manideepsai-art/sartac-vishwakarma-2026/README.md

# sartac-vishwakarma-2026
SARTAC: AI-Powered Caged Drone for Collapsed-Structure Search and Rescue

A drone concept designed to support search-and-rescue operations in collapsed structures by improving situational awareness and reducing uncertainty for rescue teams.

TEAM: LogicVolt

Institution: NIT RAIPUR
