manideepsai-art/sartac-vishwakarma-2026/CAD/Screenshot 2026-10-25 131847.png

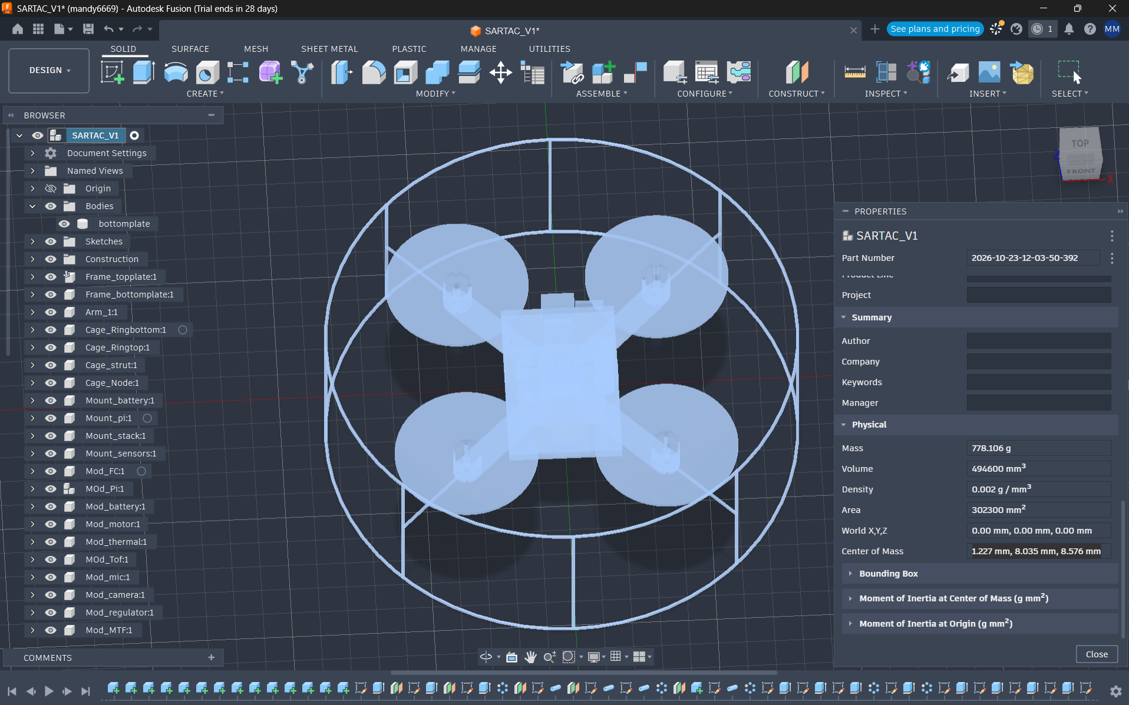
CAD/Screenshot 2026-10-25 131847.png
