manideepsai-art/sartac-vishwakarma-2026/CAD/Screenshot 2026-10-25 135739.png

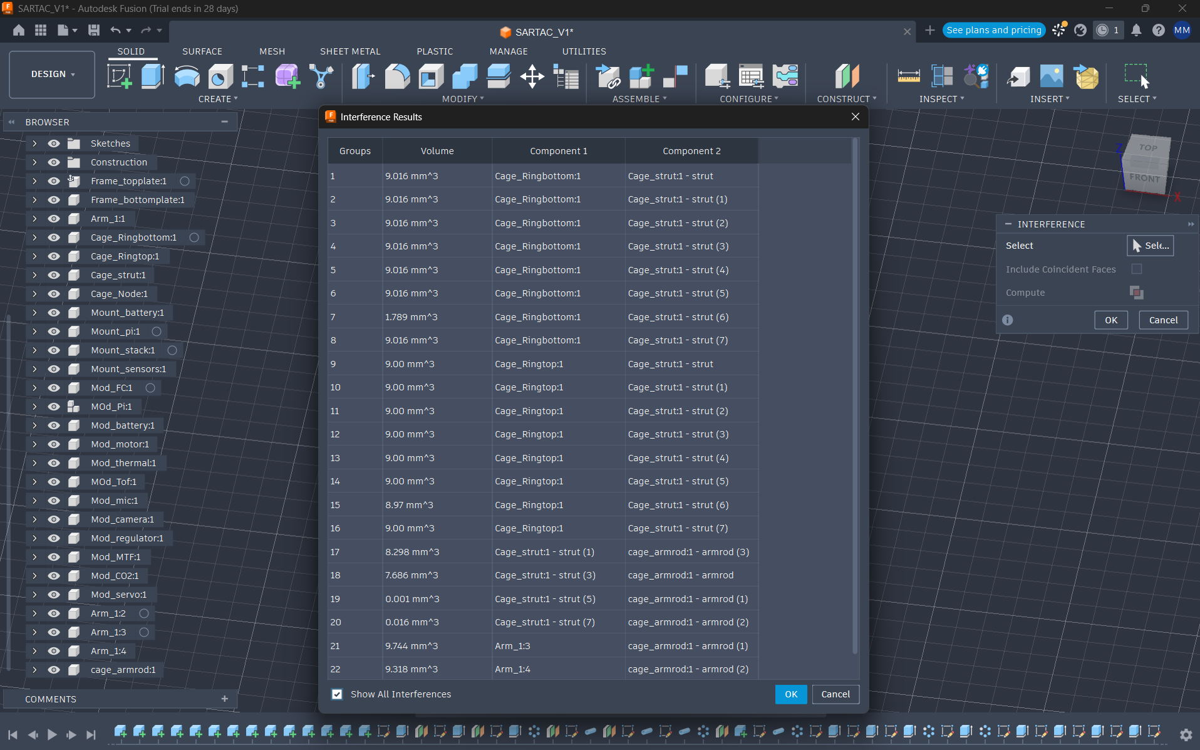
CAD/Screenshot 2026-10-25 135739.png
