manideepsai-art/sartac-vishwakarma-2026/CAD/Screenshot 2026-10-25 140053.png

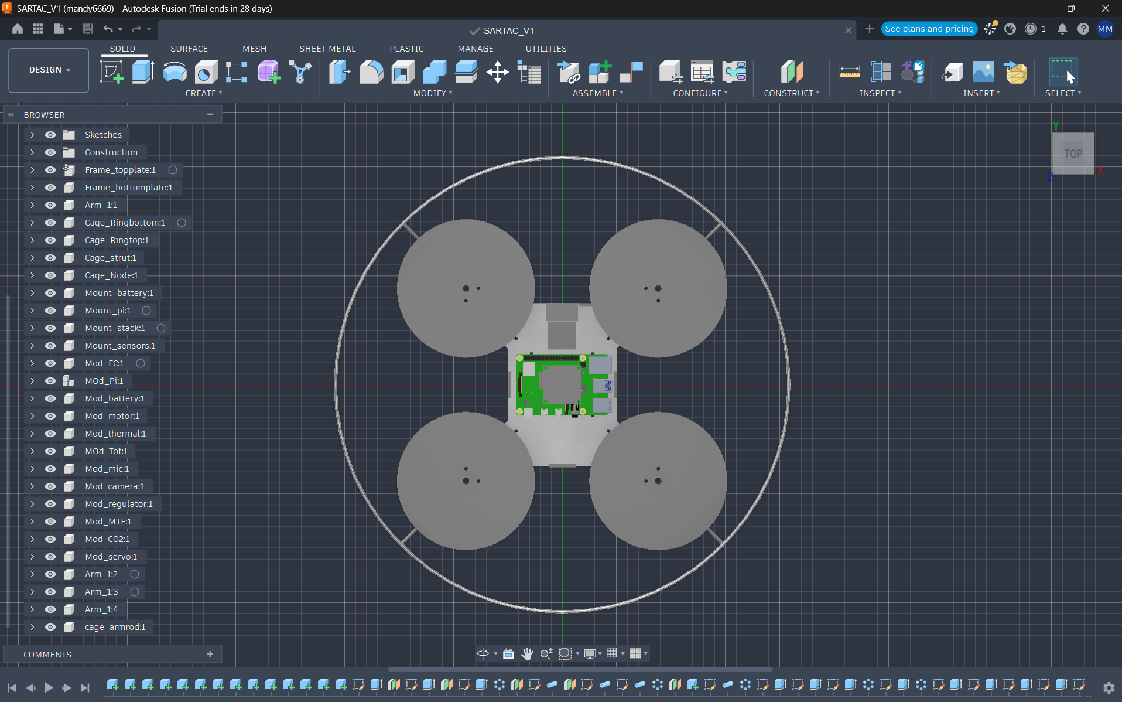
CAD/Screenshot 2026-10-25 140053.png
