manideepsai-art/sartac-vishwakarma-2026/electronics/erc_clean.png

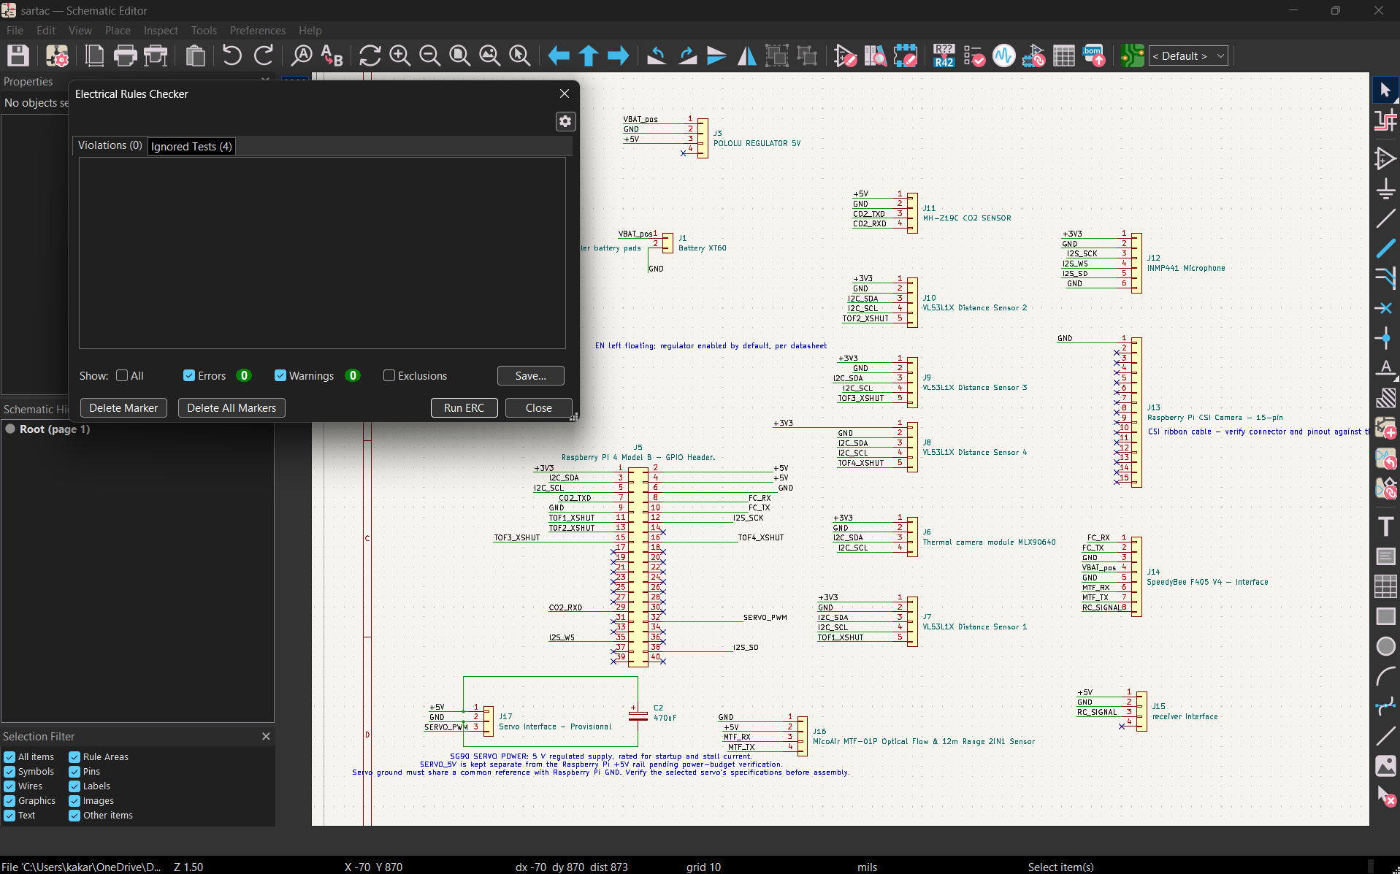
electronics/erc_clean.png
