manideepsai-art/sartac-vishwakarma-2026/bom/SARTAC BOM.xlsx

Priority | Phase | Part | Model | Size(L*W*H) | Mass | Mounting holes | Voltage | Current | Interface | Price | Vendor | Product link | Lead time | Local/Imported | Quantity
1 | prototype | Companion Computer | Raspberry Pi 4 Model B (2GB RAM) | 88 × 58 × 19.5 mm | 46 g | 4× M2.5 (58×49mm) | 5.0V - 5.1V DC | 3.0A (Min PSU) / 0.6A - 2.5A (Operating) | 40-pin GPIO, 2x USB 3.0, 2x USB 2.0, Gigabit Ethernet, Wi-Fi, BT 5.0, CSI, DSI, Micro-HDMI | ₹8,279 | Amazon.in | https://www.amazon.in/Raspberry-Pi-Computer-Model-2GB/dp/B07TD42S27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 | 1–3 Days | Local | 1
1 | prototype | FC & ESC Stack | SpeedyBee F405 V4 BLS 55A Stack | 41.6 × 45.6 × 17 mm | 35 g (Stack only) | 30.5 × 30.5 mm (Φ 4 mm / M3) | 3S – 6S LiPo (10.5V - 25.2V) | 55A Continuous × 4 (70A Burst) | USB-C, UARTs, I2C, Bluetooth, DShot300/600, OSD, Barometer | ₹9,870 | Robu.in | Robu Product Page (https://robu.in/product/f405-v4-bls-55a-30x30-fc-amp-esc-stack/) | 2–5 Days | Local | 1
1 | prototype | Brushless Motor (4 pcs) | SpeedyBee 2306.5-1800KV Motor (Set of 4) | Φ 28.7 × 32.7 mm | 34.3 g/pc (137.4 g total) | 16 × 16 mm (M3) | 6S LiPo (22.2V - 25.2V) | ~30A Max per motor (722W Max) | 3-Phase Wire Leads (20AWG, 150mm) | ₹7,299(4 pcs) | Design Info | Product Link (https://designinfo.in/p/speedybee-2306-5-1800kv-motor-master5v2-5-inch-fpv-4-pcs/) | 2–4 Days | Local | 1
2 | optional | Micro Servo Motor | TowerPro SG90 9G Micro Servo Motor 180° | 22.2 × 11.8 × 31 mm | 9 g | 2× M2 Flange Holes (28mm pitch) | 4.8V - 6.0V DC | 100 mA (Operating) / 650 mA (Stall) | Standard 3-pin PWM (Signal, VCC, GND) | ₹105 | Robocraze | Product Link (https://robocraze.com/products/sg90-micro-servo-motor) | 3–6 Days | Local | 1
2 | prototype | Distance Sensor (ToF) | VL53L1X Time-Of-Flight Distance Sensor Module | 25 × 10.7 × 3.2 mm | 1.5 g | 2× M2 Holes | 3.3V - 5.0V DC | 20 mA (Avg) / 40 mA (Peak) | I2C (SDA, SCL), XSHUT, GPIO1 | ₹525x4=2100 | Quartz Components | Product Link (https://quartzcomponents.com/products/nano-a000005) | 2–4 Days | Local | 4
1 | prototype | LiPo Battery Pack (6S) | Orange Pro-Range 22.2V 1000mAh 35C 6S | 75 × 33.5 × 36 mm | 180 g | N/A | 22.2V - 25.2V (6S) | 35A Continuous (35C) | XT60 (Power) + JST-XH 6S (Balance) | ₹2,709 | Robu.in | Product Link (https://robu.in/product/pro-range-22-2v-1000mah-35c-6s-lithium-polymer-battery-pack/) | 3–6 Days | Local | 1
2 | prototype | Thermal Camera Sensor | MLX90640 55° FOV Thermal Camera Breakout (7Semi) | 29 × 25 × 16 mm | 5 g | 2× M2 Holes | 3.3V - 5.0V DC | < 23 mA | I2C, Qwiic Connector, 5-pin Header | ₹4,585 | Robocraze | Product Link (https://robocraze.com/products/mlx90640-55-fov-thermal-camera-ir-array-breakout-qwiic-compatible-7semi) | 2–5 Days | Local | 1
2 | prototype | Optical Camera | 5MP Raspberry Pi Camera Module Rev 1.3 (OV5647) | 25 × 24 × 9 mm | 3 g | 4× M2 (21×12.5 mm spacing) | 3.3V DC (via CSI) | ~250 mA | 15-pin MIPI CSI Ribbon Cable | ₹319 | Robu.in | Robu Product Link (https://robu.in/product/raspberry-pi-camera-module/) | 2–5 Days | Local | 1
2 | prototype | Microphone sensor | INMP441 MEMS I2S Microphone Module | Φ 15 × 3 mm | 1.5 g | 2× M2 Notches | 1.8V - 3.3V DC | ~1.4 mA | Digital I2S (SCK, WS, SD, L/R) | ₹179 | Robocraze | Product Link (https://robocraze.com/products/inmp441-mems-high-precision-omnidirectional-microphone-module-i2s) | 2–5 Days | Local | 1
2 | optional | CO2 Sensor | MH-Z19C Infrared $CO_2$ Sensor with Terminal | 32.5 × 19.7 × 14 mm | 15 g | N/A | 4.9V - 5.1V DC | < 40mA (Avg) / < 125mA (Peak) | UART TTL, PWM, 7-Pin JST Connector | ₹3,159 | Robu.in | Robu Product Link (https://robu.in/product/infrared-carbon-dioxide-sensor-mh-z19c-with-termina/) | 2–4 Days | Local | 1
1 | prototype | Propellers (4 pcs) | Gemfan Hurricane 51466 V2 PC 3 Blade | 129.5 × 129.5 × 14 mm (5.1") | 4.2 g/pc (16.8 g total) | 5 mm Shaft Hole | N/A | N/A | Standard M5 Locknut Mount | ₹259(4 pcs) | Design Info | Product Link (https://designinfo.in/p/gemfan-hurricane-51466-v2-pc-3-blade-wave-blue/) | 2–5 Days | Local | 4
2 | prototype | Optical Flow & Range Sensor | MicoAir MTF-01P Optical Flow & 12m Range 2IN1 Sensor | 29.3 × 17 × 15 mm | 4.5 g | 2× M2 Holes (25mm pitch) | 4.5V - 5.5V DC | 40–50 mA | UART TTL (ArduPilot/INAV/Betaflight) | ₹3,399 | Anubis RC | Product Link (https://anubisrc.com/product/micoair-mtf-01p-optical-flow-12m-range-2in1-sensor/) | 2–4 Days | Local | 1
3 | prototype | Step-Down Regulator | Pololu 5V, 5.5A Step-Down Regulator D36V50F5 | 25.4 × 25.4 × 9.5 mm | 7 g | 2× M2 Holes (20.3mm pitch) | Vin: 5.5V-50V / Vout: 5V | 5.5A Continuous | 2.54mm Pitch Headers (VIN, GND, VOUT, EN) | $42.37 (~₹3,520) | TME Electronic Components | Product Link (https://www.tme.com/in/en/details/pololu-4091/converter-modules/pololu/5v-5-5a-step-down-volt-reg-d36v50f5/) | 5–9 Days | Imported | 1
3 | prototype | Rc Reciever |  |  |  |  |  |  |  | Borrowed |  |  |  | Borrowed | 1
3 | prototype | RC Transmitter |  |  |  |  |  |  |  | Borrowed |  |  |  | Borrowed | 1
3 | post funding | Relay repeater node |  |  |  |  |  |  |  | to be quoted |  |  |  | lab | 2
3 | prototype | Carbon-fibre plate 3 mm (body + arms) |  |  | 190g |  |  |  |  | to be quoted |  |  |  | lab
3 | prototype | Carbon-fibre rods 3 mm (cage) |  |  | 45g |  |  |  |  | to be quoted |  |  |  | lab
3 | prototype | Printed parts (mounts, cage nodes) |  |  | 20g |  |  |  |  | to be quoted |  |  |  | lab
3 | prototype | Fasteners, standoffs, M2.5 / M3 |  |  | 15g |  |  |  |  | to be quoted |  |  |  | lab
3 | prototype | Wiring, connectors, solder |  |  | 20 to 30g |  |  |  |  | to be quoted |  |  |  | lab
 |  |  |  |  |  |  |  |  |  | to be quoted |  |  |  | lab
 | Total |  |  |  | 778g(CAD)
 |  |  |  |  |  |  |  |  |  | 45,872(listed parts)
