manideepsai-art/sartac-vishwakarma-2026/CAD/Arm_1.step

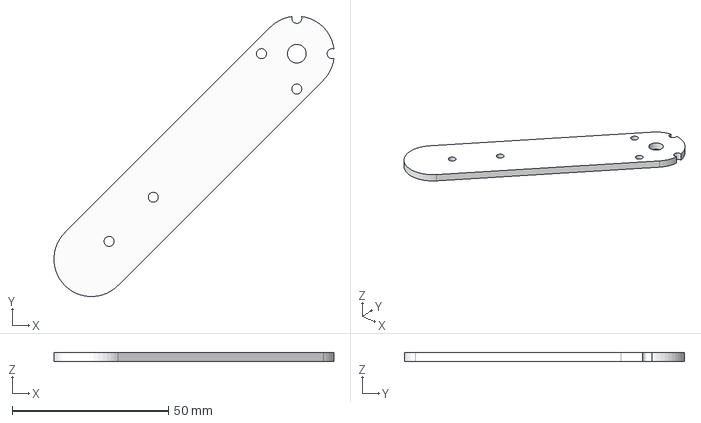
[picture p7: CAD file, 2026-10-25]
CAD/Arm_1.step
89.6 x 89.6 x 3.00 mm
