manideepsai-art/sartac-vishwakarma-2026/CAD/SARTAC_V1.step

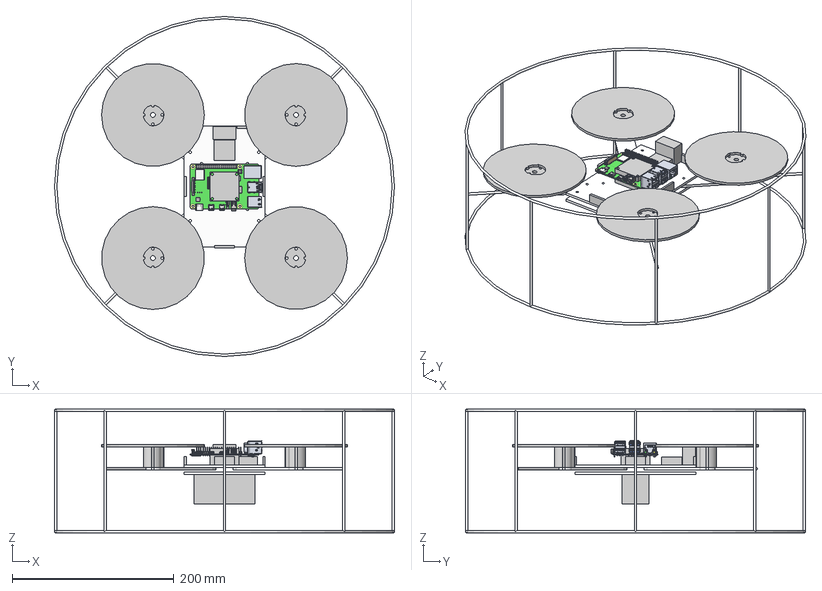
[picture p8: CAD file, 2026-10-25]
CAD/SARTAC_V1.step
420.0 x 420.0 x 153.0 mm
