manideepsai-art/sartac-vishwakarma-2026/(list of files, cad)

Other CAD files:
CAD/Arm_1.f3d
CAD/SARTAC_V1.f3d
CAD/SARTAC_V1.stl
