manideepsai-art/sartac-vishwakarma-2026/bom/SARTAC BOM - Sheet1 (5).pdf

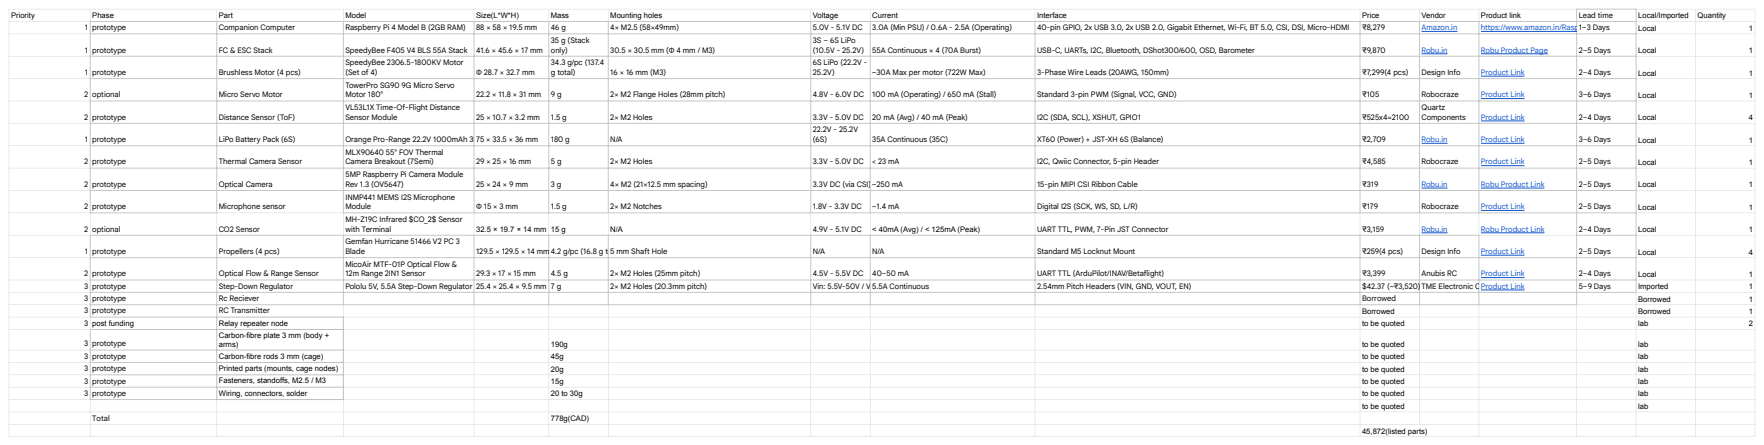
[picture p9: page 1]
Priority; Phase; Part; Model; Size(L*W*H); Mass; Mounting holes; Voltage; Current; Interface; Price; Vendor; Product link; Lead time; Local/Imported; Quantity; prototype; Companion Computer; Raspberry Pi 4 Model B (2GB RAM); 3.0A (Min PSU) / 0.6A - 2.5A (Operating); 40-pin GPIO, 2x USB 3.0, 2x USB 2.0, Gigabit Ethernet, Wi-Fi, BT 5.0, CSI, DSI, Micro-HDMI; Amazon.in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

35 g (Stack only) | 30.5 × 30.5 mm (Φ 4 mm / M3) | 3S – 6S LiPo

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
