manideepsai-art/sartac-vishwakarma-2026/electronics/sartac.pdf

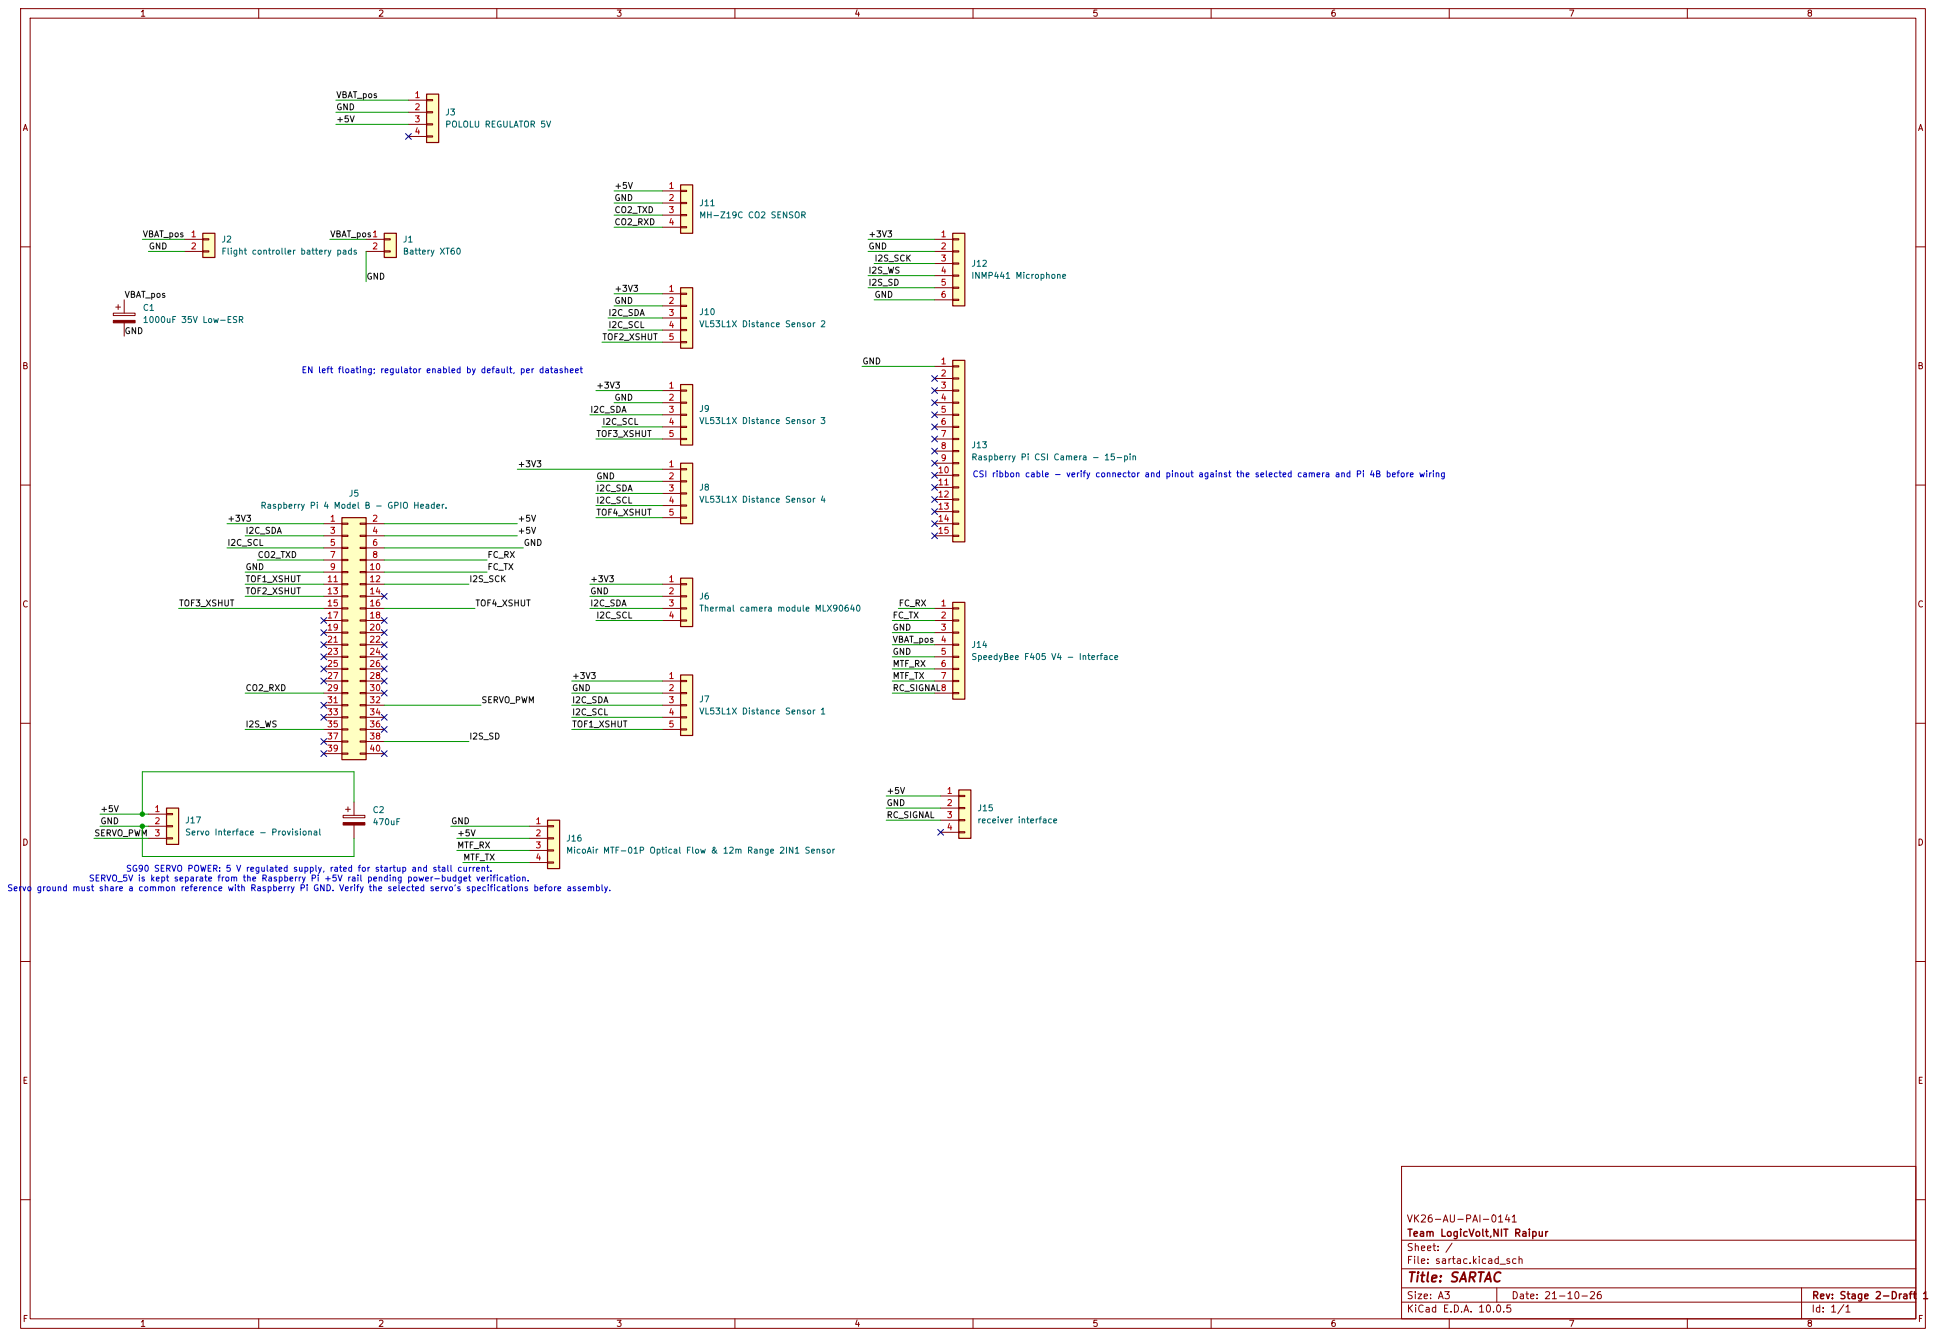
[picture p10: page 1]

EN left floating; regulator enabled by default, per datasheet

J13 Raspberry Pi CSI Camera - 15-pin 1

J16 MicoAir MTF-01P Optical Flow & 12m Range 2IN1 Sensor 1

VK26-AU-PAI-0141
Team LogicVolt,NIT Raipur
Sheet: /
File: sartac.kicad_sch
Title: SARTAC

F Date: 21-10-26

KiCad E.D.A. 10.0.5 | Id: 1/1
