manideepsai-art/sartac-vishwakarma-2026/electronics/sartac.kicad_sch

## KiCad design electronics/sartac.kicad_sch (2026-10-21)

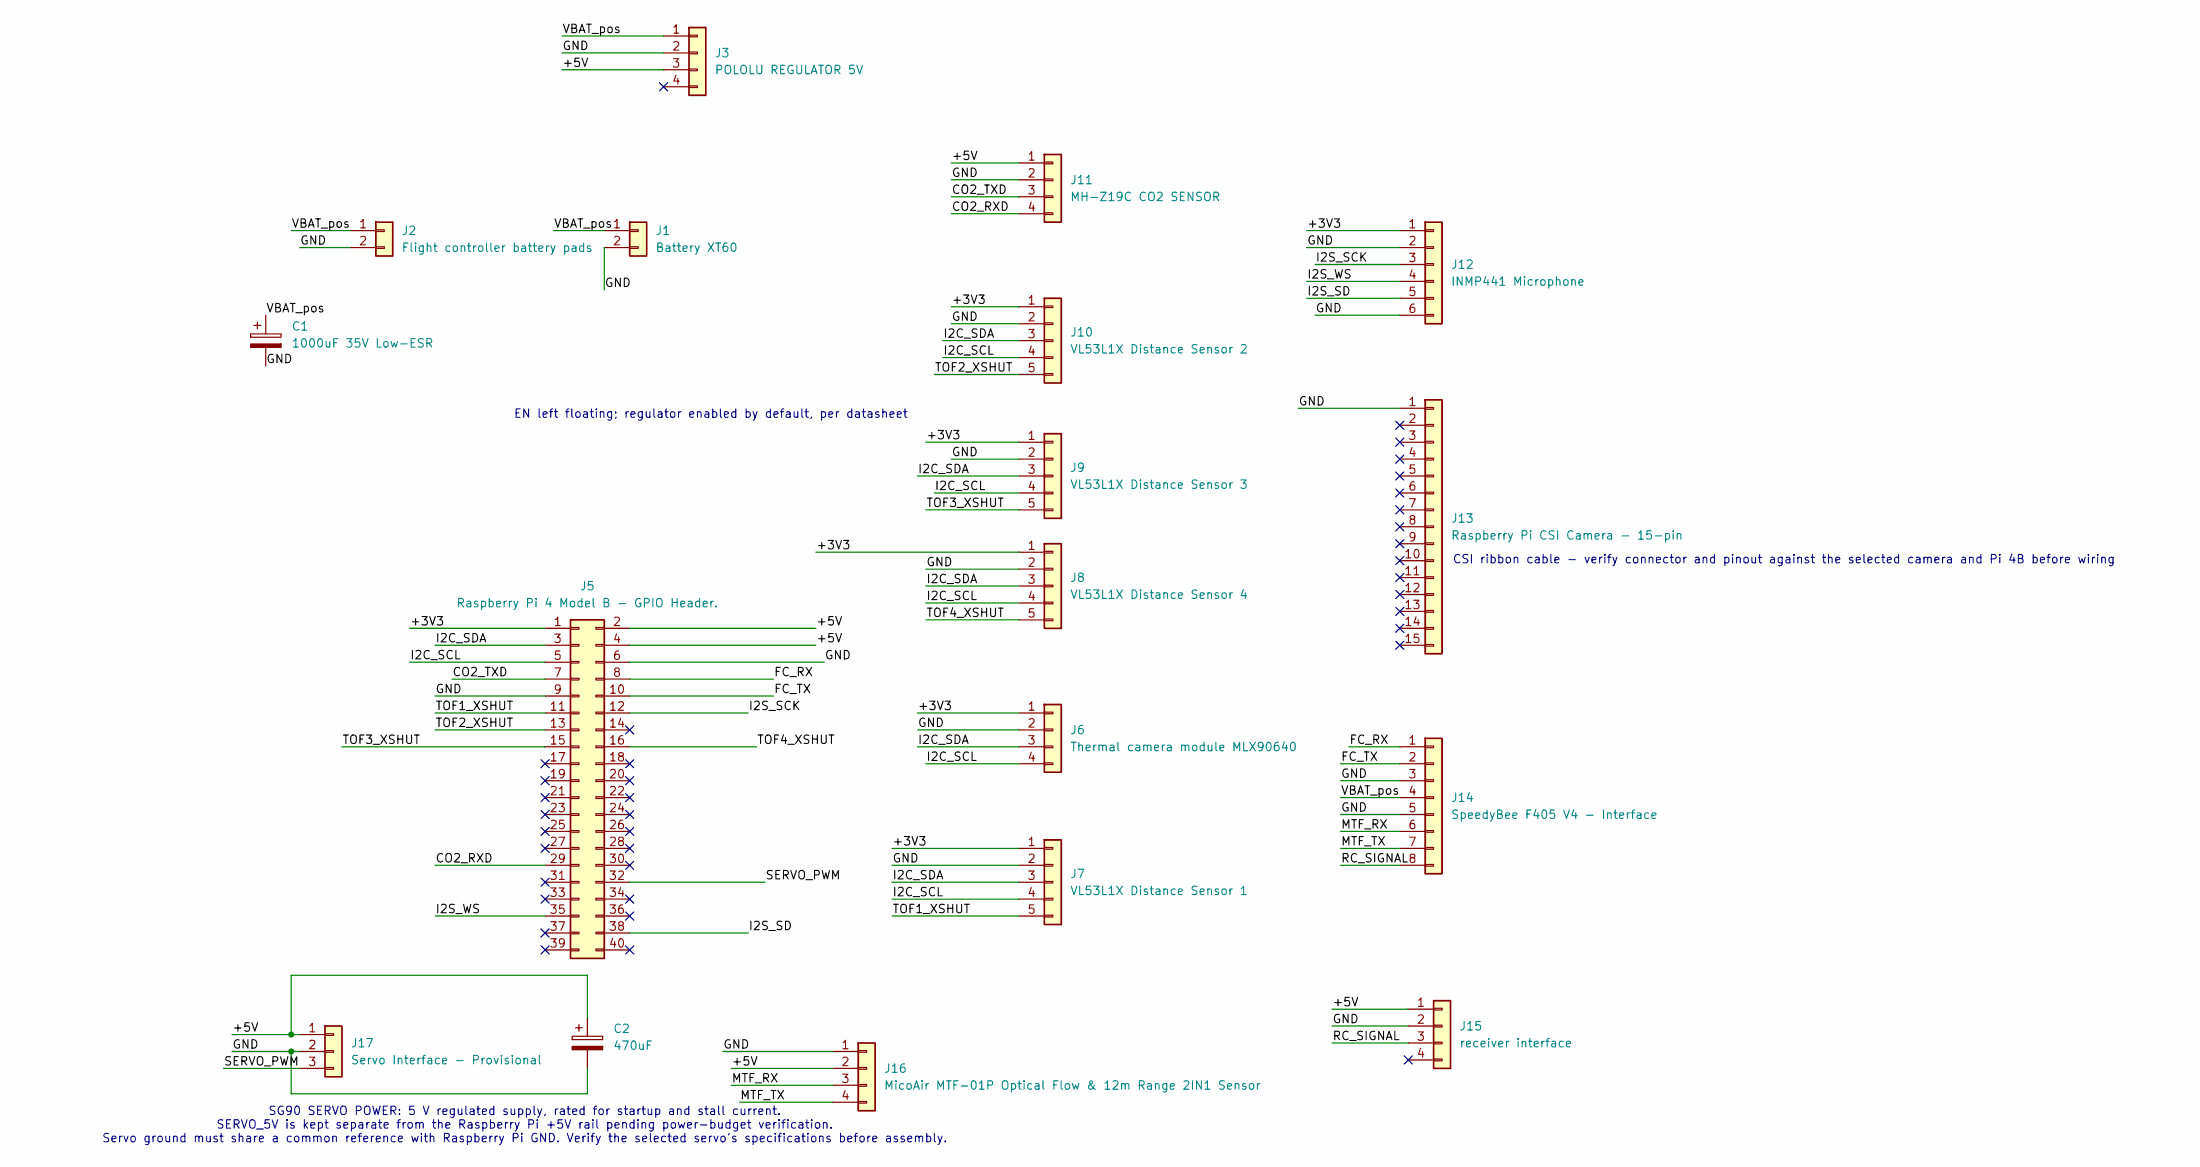
[picture p11: schematic sartac.kicad_sch]

Parts:
C1: 1000uF 35V Low-ESR
C2: 470uF
J1: Battery XT60
J2: Flight controller battery pads
J3: POLOLU REGULATOR 5V
J5: Raspberry Pi 4 Model B - GPIO Header.
J6: Thermal camera module MLX90640
J7: VL53L1X Distance Sensor 1
J8: VL53L1X Distance Sensor 4
J9: VL53L1X Distance Sensor 3
J10: VL53L1X Distance Sensor 2
J11: MH-Z19C CO2 SENSOR
J12: INMP441 Microphone
J13: Raspberry Pi CSI Camera - 15-pin
J14: SpeedyBee F405 V4 - Interface
J15: receiver interface
J16: MicoAir MTF-01P Optical Flow & 12m Range 2IN1 Sen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
J17: Servo Interface - Provisional

Connections:
+3V3: J5.1, J6.1, J7.1, J8.1, J9.1, J10.1, J12.1
+5V: C2.1, J3.3, J5.2, J5.4, J11.1, J15.1, J16.2, J17.1
CO2_RXD: J5.29, J11.4
CO2_TXD: J5.7, J11.3
FC_RX: J5.8, J14.1
FC_TX: J5.10, J14.2
GND: C1.2, C2.2, J1.2, J2.2, J3.2, J5.6, J5.9, J6.2, J7.2, J8.2, J9.2, J10.2, J11.2, J12.2, J12.6, J13.1, J14.3, J14.5, J15.2, J16.1, J17.2
I2C_SCL: J5.5, J6.4, J7.4, J8.4, J9.4, J10.4
I2C_SDA: J5.3, J6.3, J7.3, J8.3, J9.3, J10.3
I2S_SCK: J5.12, J12.3
I2S_SD: J5.38, J12.5
I2S_WS: J5.35, J12.4
MTF_RX: J14.6, J16.3
MTF_TX: J14.7, J16.4
RC_SIGNAL: J14.8, J15.3
SERVO_PWM: J5.32, J17.3
TOF1_XSHUT: J5.11, J7.5
TOF2_XSHUT: J5.13, J10.5
TOF3_XSHUT: J5.15, J9.5
TOF4_XSHUT: J5.16, J8.5
VBAT_pos: C1.1, J1.1, J2.1, J3.1, J14.4

Notes on the sheet:
SG90 SERVO POWER: 5 V regulated supply, rated for startup and stall current. SERVO_5V is kept separate from the Raspberry Pi +5V rail pending power-budget verification. Servo ground must share a common reference with Raspberry Pi GND. Verify the selected servo's specifications before assembly.
EN left floating; regulator enabled by default, per datasheet
CSI ribbon cable - verify connector and pinout against the selected camera and Pi 4B before wiring
