manideepsai-art/sartac-vishwakarma-2026/(commit log)

2026-10-19 Create raspberry pi 4B
2026-10-19 Create KICAD_pro
